Diogonac/DAC-R2R/images/sup_imag.png

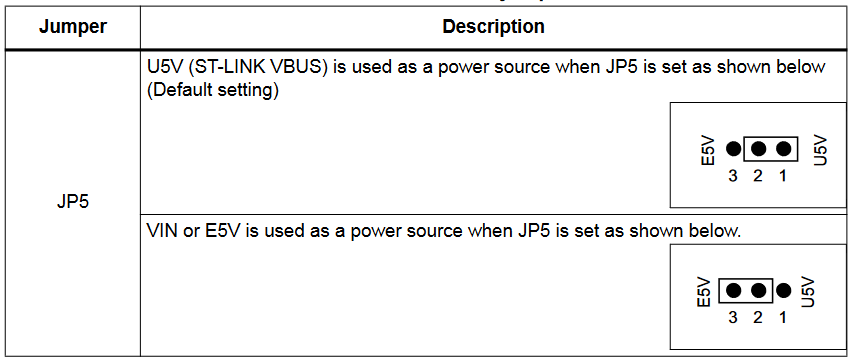
images/sup_imag.png
