Diogonac/DAC-R2R/(list of files, drawings)

Other design files:
proteus/DAC_R2R_v2.pdsprj
